edf1101/TemperatureTracker/res/BOM_Temperature Humidity Logger_PCB_2L_2025-11-09.xlsx

No. | Quantity | Designator | Footprint | Value
1 | 1 | BAT | COIN-BATTERY-HOLDER_LINX_BAT-HLD-001_D20MM
2 | 1 | C1 | ELECTROLYTIC POLARIZED 4MM DIAMETER CAPACITOR
3 | 4 | D1,D2,D3,D4 | SOD-123_L2.7-W1.6-LS3.7-RD-1
4 | 1 | PROG | HDR-F-2.54_1X4
5 | 3 | Q1,Q2,Q3 | SOT-23-3_L2.9-W1.6-P1.90-LS2.8-BR
6 | 11 | R1,R2,R3,R4,R5,R6,R7,R8,R9,R10,R11 | R0603
7 | 1 | RST_MEM | JUMPER:SOLDERJUMPER-2-MARKED
8 | 1 | SW1 | SW-TH_4P-L6.0-W6.0-P4.50-LS6.1
9 | 1 | U1 | SOIC-8_L5.0-W4.0-P1.27-LS6.0-BL
10 | 1 | U2 | BME280
11 | 1 | U3 | SSD1306
12 | 1 | U4 | SOIC-14_L8.7-W3.9-P1.27-LS6.0-BL
13 | 2 | U5,U6 | SOP-4_L6.5-W4.6-P2.54-LS10.0
