edf1101/TemperatureTracker/res/SCH_Temperature Humidity Logger_2025-11-09.pdf

# Microcontrollers

# Switches

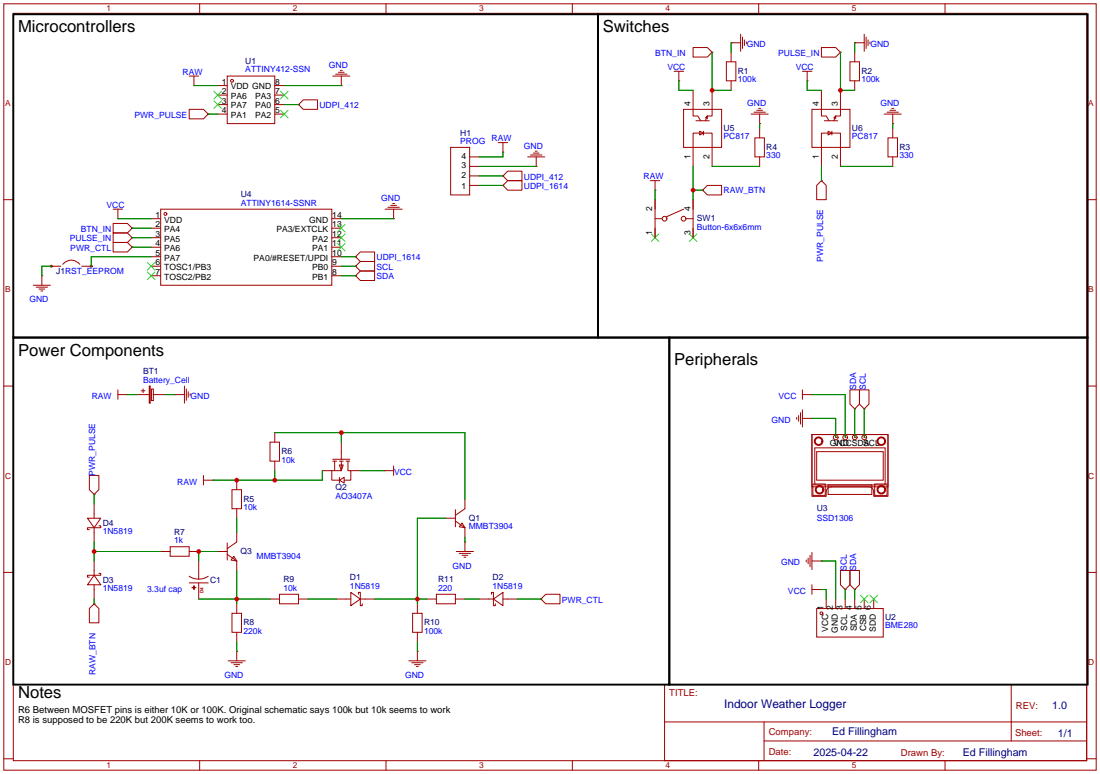
[picture p3: page 1]

Notes
R6 Between MOSFET pins is either 10K or 100K. Original schematic says 100k but 10k seems to work
R8 is supposed to be 220K but 200K seems to work too.
