edf1101/TemperatureTracker/(commit log)

2025-07-01 Working sensor + oled
2025-07-08 Wakes up and powers down with button + deep sleep
2025-07-09 Fix
    Seems to fix the issue of dodgy BME sensors
    [Sensor.cpp, Sensor.h]
2025-07-16 Basic timer controller working
    (not sure if it is low power enough yet)
2025-11-09 Fixed to prevent I2C hanging bugs
    [Display.cpp, MainController.cpp, MainController.h, Sensor.cpp, TempTimer.ino]
2025-11-09 ReadMe updates
    [BOM_Temperature Humidity Logger_PCB_2L_2025-11-09.xlsx]
2026-02-06 working version (2mo running currently)
